jpadi4/ECE-445-Notebook/README.md

# ECE 445 Group 78
Digital lab notebook based off of this project: https://github.com/OfficialPouya/Safety_Suite_For_Electric_Longboard
