jpadi4/ECE-445-Notebook/Team Meetings/250416.md

# April 16, 2025
**In attendance:**
- Deepika Batra
- Li Padilla
- Rawnie Singh

## Meeting agenda
- Li soldered most of the capacitors, resistors, MCU, and IMU onto the board
    - this means the wheatstone bridge, strain gauge connectors, and IMU lowpass filter is on the PCB
- Rawnie & Deepika worked together to add on 3 connectors and ISP
- Confirmed expected functionality of addition of zener diode by supplying ~5V to MCU & programming.
