jpadi4/ECE-445-Notebook/Images/muscle_stretches/Lumbrical.jpg

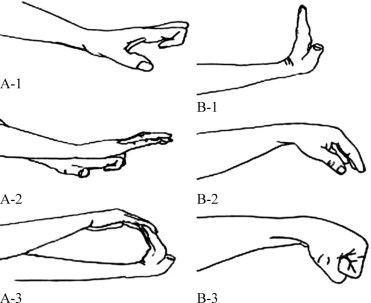
Images/muscle_stretches/Lumbrical.jpg
