jpadi4/ECE-445-Notebook/Images/muscle_stretches/Thenar1.jpg

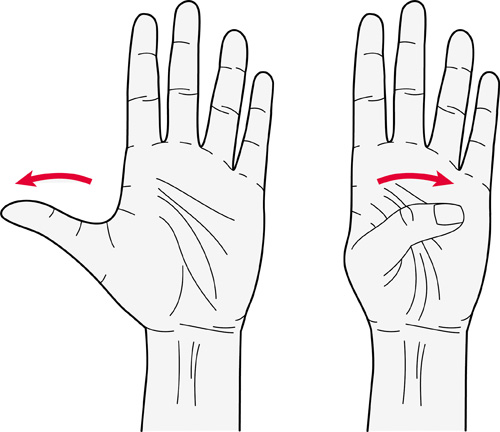
Images/muscle_stretches/Thenar1.jpg
