jpadi4/ECE-445-Notebook/Images/oldswitch.png

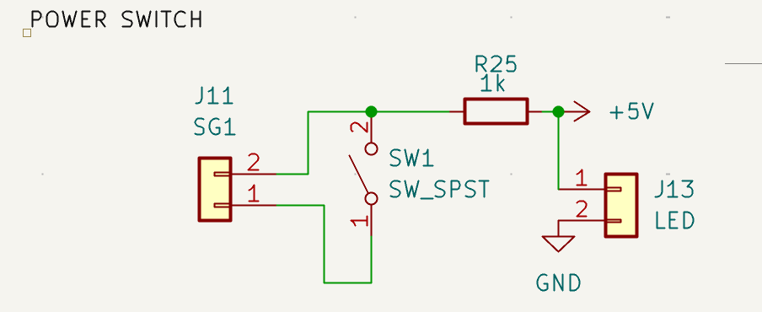
Images/oldswitch.png
