jpadi4/ECE-445-Notebook/Images/Screenshot 2025-04-30 at 11.05.38 AM.png

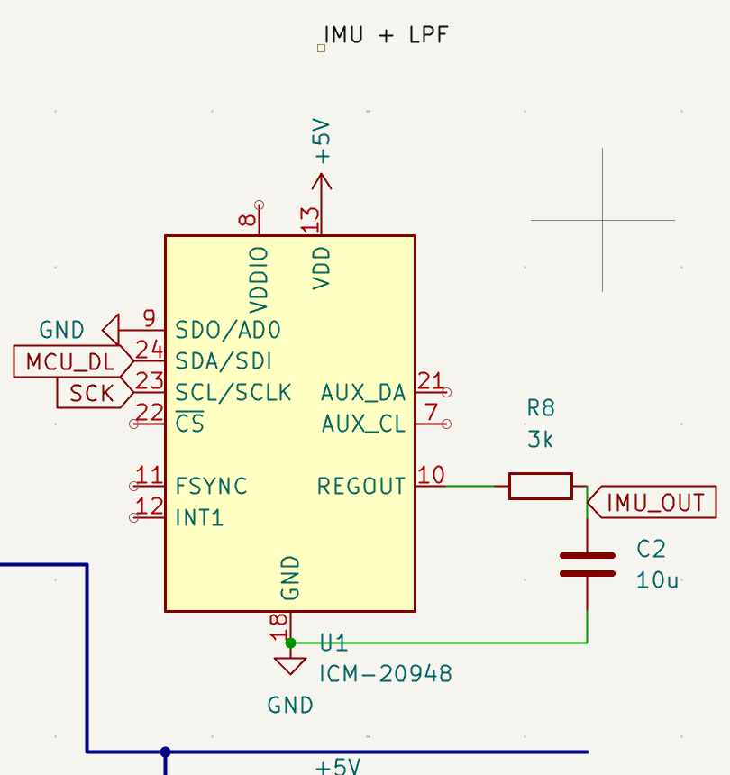
Images/Screenshot 2025-04-30 at 11.05.38 AM.png
