jpadi4/ECE-445-Notebook/Order Forms/ECE 445 Team 78 Order Form 1.27.2025.xlsx

Sheet: Order Form Fall 2024
ECE 445 SMD Component Request
 | TA Name: | Li, John |  | How to use this form:
Self Service Inventory (https://docs.google.com/spreadsheets/d/1InSHH3_mebTMyk4SWF0S2R67ZWSWq7FpKZRyKWeDHm0/edit?usp=sharing) | Group Number: | 78
E-Shop Webpage (https://ece.illinois.edu/about/eshop) | Date: | 2025-04-25 |  | 1. Enter the TA Name, Group Number, and date of request at the top.
 |  |  |  | 2. Use the drop downs to select the components needed by your team.
 | Component Requested | Quantity |  | 3. Send this form to your TA for approval and they will forward it to the E-Shop.
 | Micro Controller - ATmega328p | 3 | Maximum Quantity 3 | 4. Once the order is filled, your TA will be notified that it is available for pickup.
 |  |  | FALSE | 5. Only the TA that placed the order will be allowed to pick up the components, NO EXCEPTIONS.
 |  |  | FALSE
 |  |  | FALSE
 |  |  | FALSE
 |  |  | FALSE
 |  |  | FALSE
 |  |  | FALSE
 |  |  | FALSE
 |  |  | FALSE
 |  |  | FALSE
 |  |  | FALSE
 |  |  | FALSE
 |  |  | FALSE
 |  |  | FALSE
 |  |  | FALSE
 |  |  | FALSE
 |  |  | FALSE
 |  |  | FALSE
 |  |  | FALSE
 |  |  | FALSE
 |  |  | FALSE
 |  |  | FALSE
 |  |  | FALSE
 |  |  | FALSE
 |  |  | FALSE
 |  |  | FALSE
 |  |  | FALSE
 |  |  | FALSE
 |  |  | FALSE

Sheet: ESHOP SMD Component Guide
Component | Value | Description | Datasheet (If Known) | Part Number
Resistor - 0 Ω (0603) | 0 Ω (0603)
Resistor - 22 Ω (0603) | 22 Ω (0603) | RES 22 OHM 1% 1/10W 0603 | https://www.yageo.com/upload/media/product/products/datasheet/rchip/PYu-RC_Group_51_RoHS_L_12.pdf | RC0603FR-0722RL
Resistor - 43.2 Ω (0603) | 43.2 Ω (0603)
Resistor - 150 Ω (0603) | 150 Ω (0603)
Resistor - 182 Ω (0603) | 182 Ω (0603)
Resistor - 330 Ω (0603) | 330 Ω (0603)
Resistor - 332 Ω (0603) | 332 Ω (0603)
Resistor - 1k Ω (0603) | 1k Ω (0603)
Resistor - 4.7k Ω (0603) | 4.7k Ω (0603)
Resistor - 10k Ω (0603) | 10k Ω (0603)
Resistor - 20.5k Ω (0603) | 20.5k Ω (0603)
Resistor - 23.7k Ω (0603) | 23.7k Ω (0603)
Resistor - 27.4k Ω (0603) | 27.4k Ω (0603)
Resistor - 34k Ω (0603) | 34k Ω (0603)
Resistor - 0 Ω (0805) | 0 Ω (0805) | RES 0 OHM JUMPER 1/8W 0805 | https://www.seielect.com/catalog/sei-rmcf_rmcp.pdf | RMCF0805ZT0R00
Resistor - 330 Ω (0805) | 330 Ω (0805) | RES 330 OHM 1% 1/4W 0805 | https://www.koaspeer.com/pdfs/RK73H.pdf | RK73H2ATTD3300F
Resistor - 1k Ω (0805) | 1k Ω (0805) | RES 1K OHM 5% 1/8W 0805 | https://www.seielect.com/catalog/sei-rmcf_rmcp.pdf | RMCF0805JT1K00
Resistor - 1.5k Ω (0805) | 1.5k Ω (0805) | RES 1.5K OHM 1% 1/8W 0805 | https://www.seielect.com/catalog/sei-rmcf_rmcp.pdf | RMCF0805FT1K50
Resistor - 2.2k Ω (0805) | 2.2k Ω (0805) | RES 2.2K OHM 5% 1/8W 0805 | https://www.seielect.com/catalog/sei-rmcf_rmcp.pdf | RMCF0805JT2K20
Resistor - 5.1k Ω (0805) | 5.1k Ω (0805) | RES 5.1K OHM 5% 1/8W 0805 | https://www.seielect.com/catalog/sei-rmcf_rmcp.pdf | RMCF0805JT5K10
Resistor - 10k Ω (0805) | 10k Ω (0805) | RES 10K OHM 5% 1/8W 0805 | https://www.seielect.com/catalog/sei-rmcf_rmcp.pdf | RMCF0805JG10K0
Resistor - 100k Ω (0805) | 100k Ω (0805) | RES 100K OHM 5% 1/8W 0805 | https://www.seielect.com/catalog/sei-rmcf_rmcp.pdf | RMCF0805JT100K
Resistor - 1M Ω (0805) | 1M Ω (0805) | RES 1M OHM 1% 1/8W 0805 | https://www.seielect.com/catalog/sei-rmcf_rmcp.pdf | RMCF0805FG1M00
Capacitor - 10 pF (0603) | 10 pF (0603) | CAP CER 10PF 50V C0G/NP0 0603 | http://www.passivecomponent.com/wp-content/uploads/datasheet/WTC_MLCC_General_Purpose.pdf | 0603N100J500CT
Capacitor - 22 pF (0603) | 22 pF (0603) | CAP CER 22PF 50V C0G/NP0 0603 | http://www.passivecomponent.com/wp-content/uploads/datasheet/WTC_MLCC_General_Purpose.pdf | 0603N220J500CT
Capacitor - .01µF | .01µF | CAP CER .01 µF 16V X7R 0603 | https://connect.kemet.com:7667/gateway/IntelliData-ComponentDocumentation/1.0/download/datasheet/C0603C103K4RACTU | C0603C103K4RAC7867
Capacitor - .1µF | .1µF | CAP CER 0.1UF 16V X7R 0603 | https://connect.kemet.com:7667/gateway/IntelliData-ComponentDocumentation/1.0/download/datasheet/C0603C104K4RACTU | C0603C104K4RAC7867
Capacitor - .22µF | .22µF | CAP CER 0.22UF 10V X7R 0603 | https://connect.kemet.com:7667/gateway/IntelliData-ComponentDocumentation/1.0/download/datasheet/C0603C224K8RACTU | C0603C224K8RAC7867
Capacitor - 1µF | 1µF | CAP CER 1UF 6.3V X5R 0603 | https://connect.kemet.com:7667/gateway/IntelliData-ComponentDocumentation/1.0/download/datasheet/C0603C105K9PACTU | C0603C105K9PAC7867
Capacitor - 4.7µF | 4.7µF | CAP CER 4.7UF 6.3V X5R 0603 | https://connect.kemet.com:7667/gateway/IntelliData-ComponentDocumentation/1.0/download/datasheet/C0603C475K9PACTU | C0603C475K9PAC7867
Capacitor - .001 µF (0805) | .001 µF (0805) | CAP CER .001µF 50V X7R 0805 | https://www.samsungsem.com/kr/support/product-search/mlcc/CL21B102KBANNNC.jsp | CL21B102KBANNNC
Capacitor - .01µF (0805) | .01µF (0805) | CAP CER .01µF 100V X7R 0805 | http://www.samsungsem.com/kr/support/product-search/mlcc/CL21B103KCANNNC.jsp | CL21B103KCANNNC
Capacitor - .1 µF (0805) | .1 µF (0805) | CAP CER 0.1UF 25V Y5V 0805 | https://www.samsungsem.com/resources/file/global/support/product_catalog/MLCC.pdf | CL21F104ZAANNNC
Capacitor - 1 µF (0805) | 1 µF (0805) | CAP CER 1UF 50V X7R 0805 |  | CL21B105KBFNNNG
Capacitor - 4.7 µF (0805) | 4.7 µF (0805) | CAP CER 4.7UF 25V X5R 0805 |  | CL21A475KAQNNNE
Capacitor - 10 µF (0805) | 10 µF (0805) | CAP CER 10UF 50V X5R 0805 | https://search.murata.co.jp/Ceramy/image/img/A01X/G101/ENG/GRM21BR61H106ME43-01A.pdf | GRM21BR61H106ME43L
Capacitor - 33 µF (0805) | 33 µF (0805) | CAP CER 33UF 10V X5R 0805 | https://product.tdk.com/system/files/dam/doc/product/capacitor/ceramic/mlcc/catalog/mlcc_commercial_general_en.pdf | C2012X5R1A336M125AC
Voltage Regulator - AZ1117CD-3.3TRG1 | AZ1117CD-3.3TRG1 | IC REG LINEAR 3.3V 1A TO252-2 | https://www.diodes.com/assets/Datasheets/AZ1117C.pdf | AZ1117CD-3.3TRG1
Voltage Regulator - AP2112K-3.3TRG1 | AP2112K-3.3TRG1 | IC REG LINEAR 3.3V 600MA SOT25 | https://www.diodes.com/assets/Datasheets/AP2112.pdf | AP2112K-3.3TRG1
Voltage Regulator - BD50FC0FP-E2 | BD50FC0FP-E2 | IC REG LINEAR 5V 1A TO252-3 | https://www.rohm.com/datasheet?p=BD50FC0FP&dist=Digi-key&media=referral&campaign=Digi-key | BD50FC0FP-E2
Voltage Regulator - TPS7A2050PDBVR | TPS7A2050PDBVR | IC REG LINEAR 5V 300MA SOT23-5 | https://www.ti.com/general/docs/suppproductinfo.tsp?distId=10 | TPS7A2050PDBVR
Diode - CDBA540-HF | CDBA540-HF | DIODE SCHOTTKY 40V 5A DO214AC |  | CDBA540-HF
Diode - 1SMB5919BT3 | 1SMB5919BT3 | DIODE ZENER 5.6V 3W SMB |  | 1SMB5919BT3
Diode - SP0503BAHTG | SP0503BAHTG | TVS DIODE 5.5VWM 8.5VC SOT143-4 | https://www.littelfuse.com/~/media/electronics/datasheets/tvs_diode_arrays/littelfuse_tvs_diode_array_sp05_datasheet.pdf.pdf | SP0503BAHTG
Diode - BAT54SLT1G | BAT54SLT1G | DIODE ARR SCHOTT 30V 200MA SOT23 | https://www.onsemi.com/pdf/datasheet/bat54slt1-d.pdf | BAT54SLT1G
Diode - LTST-C150CKT | LTST-C150CKT | LED RED CLEAR 1206 SMD | https://optoelectronics.liteon.com/upload/download/DS-22-98-0002/LTST-C150CKT.pdf | LTST-C150CKT
Fuse - 0451002.MRL | 0451002.MRL | FUSE BRD MNT 2A 125VAC/VDC 2SMD | https://www.littelfuse.com/media?itemid=533cd5cc-956c-4243-867f-6ab5a62f6ba1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 | 0451002.MRL
Transistor - SS8050-G | SS8050-G | TRANS NPN 25V 1.5A SOT23-3 | https://www.comchiptech.com/admin/files/product/SS8050-G RevA181526.pdf | SS8050-G
IC - UCC27324DGNRG4 | UCC27324DGNRG4 | IC GATE DRVR LOW-SIDE 8MSOP | https://www.ti.com/lit/ds/symlink/ucc37323.pdf | UCC27324DGNRG4
IC - UCC25705DGKTR | UCC25705DGKTR | IC REG CTRLR MULT TOP 8VSSOP | https://www.ti.com/lit/ds/slus473b/slus473b.pdf | UCC25705DGKTR
Comparator - LM393DR2 | LM393DR2 | IC COMP DUAL OFFSET LV 8SOIC | https://www.onsemi.com/pdf/datasheet/lm393-d.pdf | LM393DR2
Timer - TL555CDT | TL555CDT |  |  | TL555CDT
Op Amp - LMV922MX | LMV922MX |  |  | LMV922MX
Op Amp - UA741CDT | UA741CDT | IC OPAMP GP 1 CIRCUIT 8SOIC | https://www.st.com/content/ccc/resource/technical/document/datasheet/group1/d6/9e/4e/8a/fa/65/4c/d0/CD00001252/files/CD00001252.pdf/jcr:content/translations/e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 | UA741CDT
Ferrite Bead - MI0805K400R-10 | MI0805K400R-10 | FERRITE BEAD 40 OHM 0805 1LN | https://www.laird.com/document/datasheet/mi0805k400r-10-datasheet | MI0805K400R-10
MOSFET - IRLML0030TRPBF | IRLML0030TRPBF | MOSFET N-CH 30V 5.3A SOT23 | https://www.infineon.com/dgdl/irlml0030pbf.pdf?fileId=5546d462533600a401535664773825df | IRLML0030TRPBF
MOSFET - DMP2045U-7 | DMP2045U-7 | MOSFET P-CH 20V 4.3A SOT23 | https://www.diodes.com/assets/Datasheets/DMP2045U.pdf | DMP2045U-7
MOSFET - 2N7002MTF | 2N7002MTF | MOSFET N-CH 60V 115MA SOT23-3 |  | 2N7002MTF
MOSFET - FDS6680A | FDS6680A | MOSFET N-CH 30V 12.5A 8SOIC | https://www.onsemi.com/pdf/datasheet/fds6680a-d.pdf | FDS6680A
MOSFET - IRFR18N15DPBF | IRFR18N15DPBF | MOSFET N-CH 150V 18A DPAK | https://www.infineon.com/dgdl/irfr18n15dpbf.pdf?fileId=5546d462533600a40153562d7a002069 | IRFR18N15DPBF
MOSFET - SI7846DP-T1 | SI7846DP-T1 |  |  | SI7846DP-T1
MOSFET - IRLL014NTRPBF | IRLL014NTRPBF | MOSFET N-CH 55V 2A SOT223 | https://www.infineon.com/dgdl/irll014npbf.pdf?fileId=5546d462533600a401535664368425cf | IRLL014NTRPBF
Micro Controller (3 Max) - ESP32-S3-WROOM | ESP32-S3-WROOM | RF TXRX MODULE BT PCB TRACE SMD | https://www.espressif.com/sites/default/files/documentation/esp32-s3-wroom-1_wroom-1u_datasheet_en.pdf | ESP32-S3-WROOM-1-N16
Micro Controller (3 Max) - ATmega32u4 | ATmega32u4 | IC MCU 8BIT 32KB FLASH 44TQFP | http://ww1.microchip.com/downloads/en/DeviceDoc/Atmel-7766-8-bit-AVR-ATmega16U4-32U4_Summary.pdf | ATMEGA32U4-AUR
Micro Controller (3 Max) - ATmega328p | ATmega328p | IC MCU 8BIT 32KB FLASH 32TQFP | https://ww1.microchip.com/downloads/en/DeviceDoc/ATmega48A-PA-88A-PA-168A-PA-328-P-DS-DS40002061B.pdf | ATMEGA328P-AUR
Micro Controller (3 Max) - STM32F103C8 | STM32F103C8 | IC MCU 32BIT 64KB FLASH 48LQFP | https://www.st.com/resource/en/datasheet/stm32f103cb.pdf | STM32F103C8T6TR
Micro Controller (3 Max) - STM32F401RBT6 | STM32F401RBT6 | IC MCU 32BIT 128KB FLASH 64LQFP | https://www.st.com/content/ccc/resource/technical/document/datasheet/9e/50/b1/5a/5f/ae/4d/c1/DM00086815.pdf/files/DM00086815.pdf/jcr:content/translations/en.D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 | STM32F401RBT6
Connector - Micro USB-B Connector | Micro USB-B Connector | CONN RCPT USB2.0 MICRO B SMD R/A | https://www.amphenol-cs.com/media/wysiwyg/files/drawing/10118194.pdf | 10118194-0001LF
Switch - Switch Tactile | Switch Tactile | SWITCH TACTILE SPST-NO 0.05A 12V | https://www.ckswitches.com/media/1471/pts645.pdf | PTS645SL43SMTR92 LFS
Header - 4 Position Female Dupont | 4 Position Female Dupont | CONN HDR 4POS 0.1 TIN PCB |  | PPTC041LFBN-RC
Header - 3 Position Female Dupont | 3 Position Female Dupont | CONN HDR 3POS 0.1 GOLD PCB |  | PPPC031LFBN-RC
Header - 3x2 Programming Header | 3x2 Programming Header | CONN HEADER VERT 6POS 2.54MM | https://www.we-online.com/components/products/datasheet/61200621621.pdf | 61200621621
Header - 5x2 Programming Header | 5x2 Programming Header | CONN HEADER VERT 10POS 2.54MM |  | 302-S101
Connector - Edge Launch SMA Connector | Edge Launch SMA Connector | CONN SMA JACK STR 50OHM EDGE MNT |  | SMA-J-P-H-ST-EM1
Connector - 2 position terminal block (15A) | 2 position terminal block (15A) | TERM BLK 2P SIDE ENT 5.08MM PCB | https://www.phoenixcontact.com/us/products/1715721/pdf | 1715721
PC Test Point - Yellow Test Point | Yellow Test Point |  |  | 5014
PC Test Point - Orange Test Point | Orange Test Point |  |  | 5013
PC Test Point - White Test Point | White Test Point |  |  | 5012
PC Test Point - Black Test Point | Black Test Point |  |  | 5011
PC Test Point - Red Test Point | Red Test Point |  |  | 5010
