jpadi4/ECE-445-Notebook/KiCad Files/445pcb_round3.kicad_pcb

## KiCad design KiCad Files/445pcb_round3.kicad_pcb (2025-04-28)

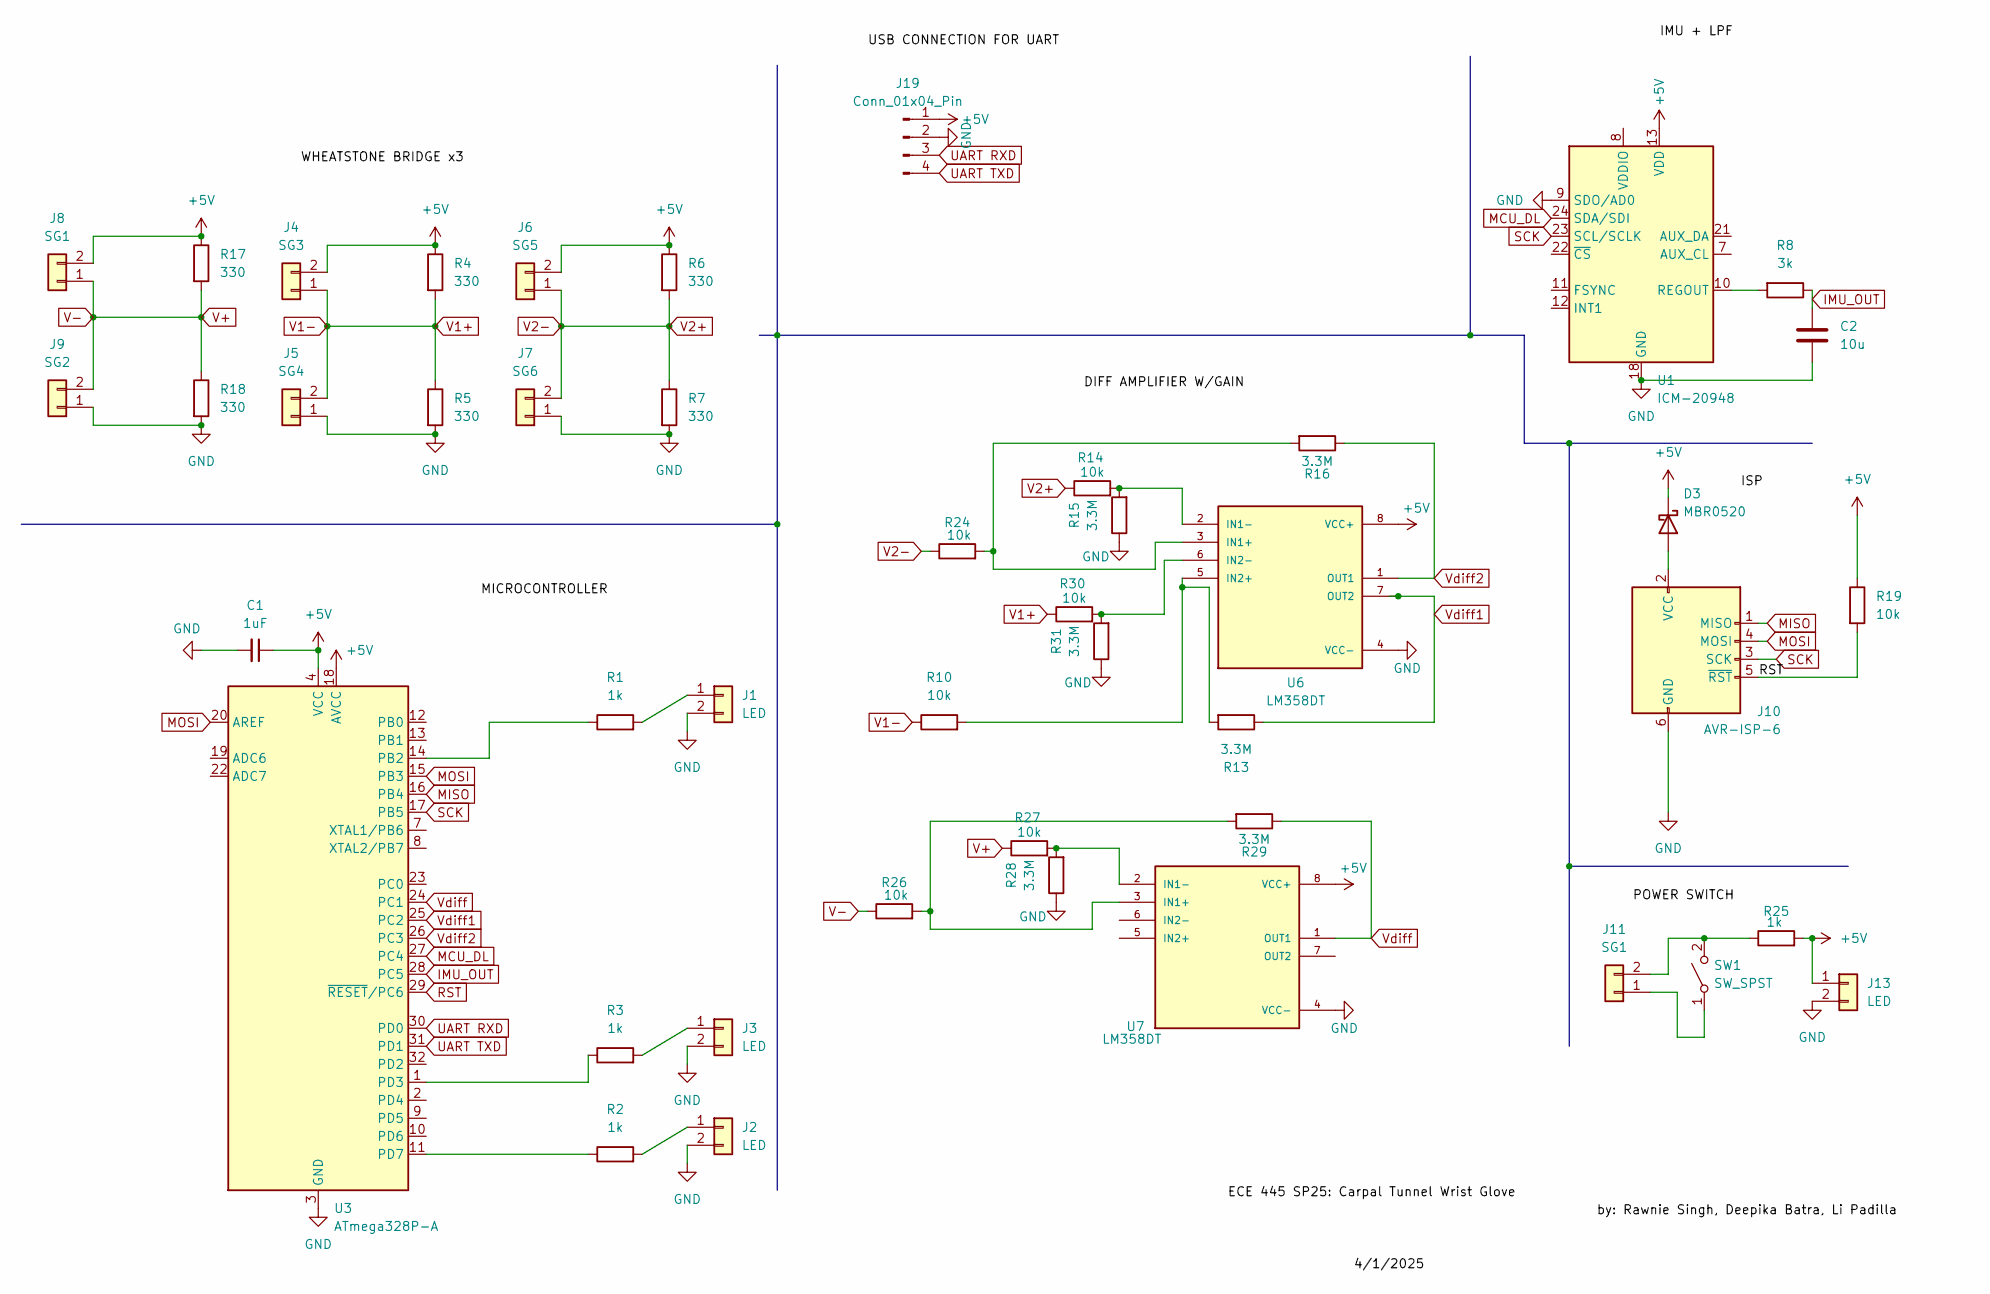
[picture p20: schematic 445pcb_round3.kicad_sch]

Parts:
C1: 1uF; C_0805_2012Metric_Pad1.18x1.45mm_HandSolder
C2: 10u; C_0805_2012Metric_Pad1.18x1.45mm_HandSolder
D3: MBR0520; D_SOD-123
J1, J2, J3, J13: LED; Molex_KK-254_AE-6410-02A_1x02_P2.54mm_Vertical
J4: SG3; Molex_KK-254_AE-6410-02A_1x02_P2.54mm_Vertical
J5: SG4; Molex_KK-254_AE-6410-02A_1x02_P2.54mm_Vertical
J6: SG5; Molex_KK-254_AE-6410-02A_1x02_P2.54mm_Vertical
J7: SG6; Molex_KK-254_AE-6410-02A_1x02_P2.54mm_Vertical
J8, J11: SG1; Molex_KK-254_AE-6410-02A_1x02_P2.54mm_Vertical
J9: SG2; Molex_KK-254_AE-6410-02A_1x02_P2.54mm_Vertical
J10: AVR-ISP-6; IDC-Header_2x03_P2.54mm_Vertical
J19: Conn_01x04_Pin; Molex_KK-254_AE-6410-04A_1x04_P2.54mm_Vertical
R1, R2, R3, R25: 1k; R_0805_2012Metric_Pad1.20x1.40mm_HandSolder
R4, R5, R6, R7, R17, R18: 330; R_0805_2012Metric_Pad1.20x1.40mm_HandSolder
R8: 3k; R_0805_2012Metric_Pad1.20x1.40mm_HandSolder
R10, R14, R19, R24, R26, R27, R30: 10k; R_0805_2012Metric_Pad1.20x1.40mm_HandSolder
R13, R15, R16, R28, R29, R31: 3.3M; R_0805_2012Metric_Pad1.20x1.40mm_HandSolder
SW1: SW_SPST; SW_DIP_SPSTx01_Slide_9.78x4.72mm_W7.62mm_P2.54mm
U1: ICM-20948; InvenSense_QFN-24_3x3mm_P0.4mm
U3: ATmega328P-A; TQFP-32_7x7mm_P0.8mm
U6, U7: LM358DT; SOIC-8_3.9x4.9mm_P1.27mm

Connections:
+5V: C1.1, D3.1 (K), J4.2, J6.2, J8.2, J13.1, J19.1, R4.1, R6.1, R17.1, R19.1, R25.2, U1.13 (VDD), U3.4 (VCC), U3.6 (VCC), U3.18 (AVCC), U6.8 (VCC+), U7.8 (VCC+)
GND: C1.2, C2.2, J1.2, J2.2, J3.2, J5.1, J7.1, J9.1, J10.6 (GND), J13.2, J19.2, R5.2, R7.2, R15.1, R18.2, R28.1, R31.1, U1.9 (SDO/AD0), U1.18 (GND), U1.20 (GND), U3.3 (GND), U3.5 (GND), U3.21 (GND), U6.4 (VCC-), U7.4 (VCC-)
IMU_OUT: C2.1, R8.1, U3.28 (PC5)
MCU_DL: U1.24 (SDA/SDI), U3.27 (PC4)
MISO: J10.1 (MISO), U3.16 (PB4)
MOSI: J10.4 (MOSI), U3.15 (PB3), U3.20 (AREF)
unnamed: D3.2 (A), J10.2 (VCC)
unnamed: J1.1, R1.2
unnamed: J2.1, R2.2
unnamed: J3.1, R3.2
unnamed: J11.1, SW1.1 (A)
unnamed: J11.2, R25.1, SW1.2 (B)
unnamed: R8.2, U1.10 (REGOUT)
unnamed: R1.1, U3.14 (PB2)
unnamed: R3.1, U3.1 (PD3)
unnamed: R2.1, U3.11 (PD7)
unnamed: R16.2, R24.2, U6.3 (IN1+)
unnamed: R14.2, R15.2, U6.2 (IN1-)
unnamed: R10.2, R13.2, U6.5 (IN2+)
unnamed: R30.2, R31.2, U6.6 (IN2-)
unnamed: R26.2, R29.2, U7.3 (IN1+)
unnamed: R27.2, R28.2, U7.2 (IN1-)
RST: J10.5 (~RST), R19.2, U3.29 (~RESET/PC6)
SCK: J10.3 (SCK), U1.23 (SCL/SCLK), U3.17 (PB5)
UART RXD: J19.3, U3.30 (PD0)
UART TXD: J19.4, U3.31 (PD1)
V1+: J4.1, J5.2, R4.2, R5.1, R10.1, R30.1
V2+: J6.1, J7.2, R6.2, R7.1, R14.1, R24.1
V+: J8.1, J9.2, R17.2, R18.1, R26.1, R27.1
Vdiff: R29.1, U3.24 (PC1), U7.1 (OUT1)
Vdiff1: R13.1, U3.25 (PC2), U6.7 (OUT2)
Vdiff2: R16.1, U3.26 (PC3), U6.1 (OUT1)

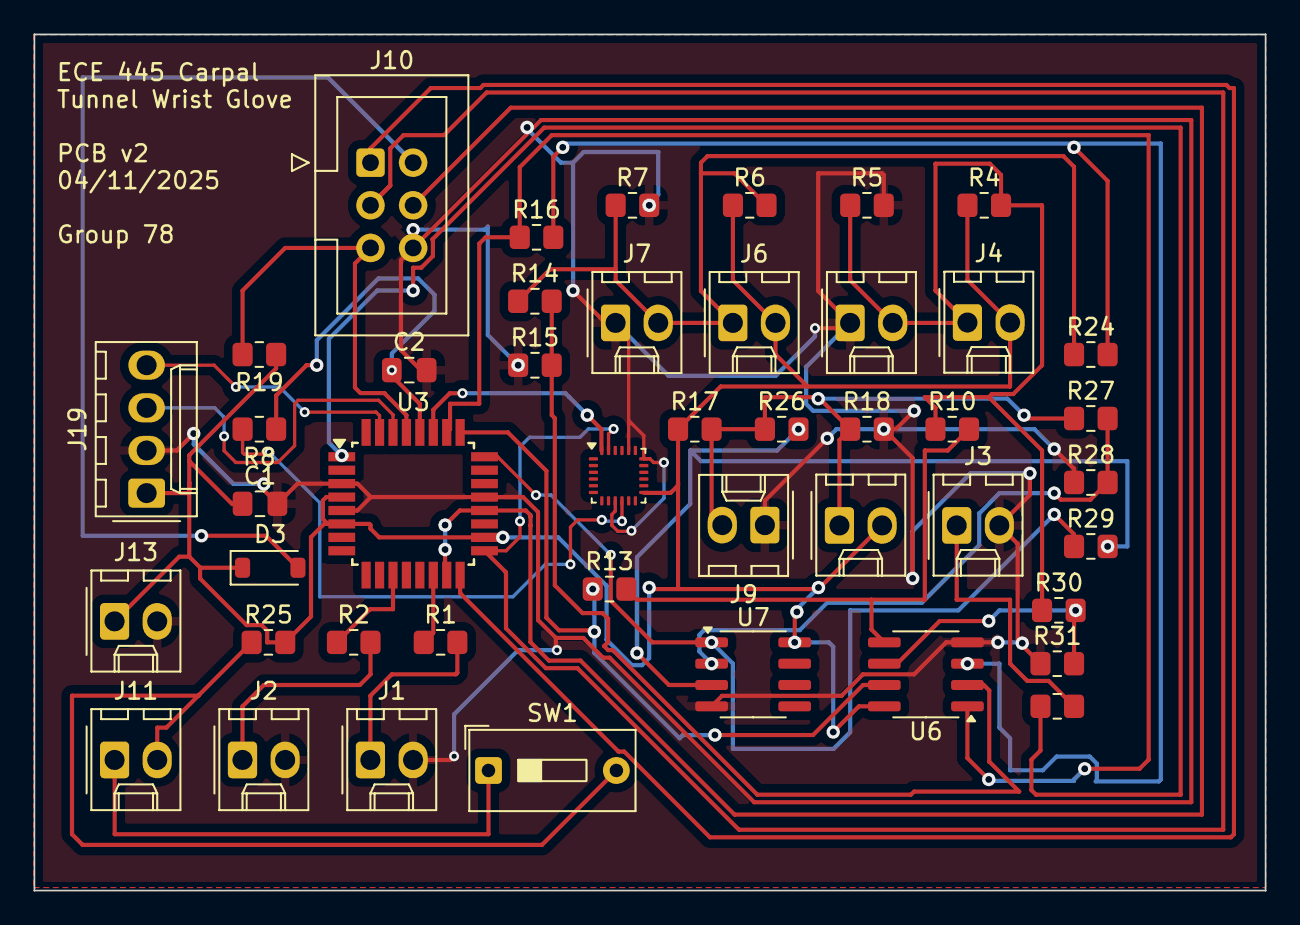
[picture p21: board 445pcb_round3.kicad_pcb from above]

Board: 2 copper layers, 73.3 x 51.0 mm, 45 parts (0 on the bottom side), 32 nets.
