jpadi4/ECE-445-Notebook/(commit log)

2025-03-10 Add new Arduino program
2025-04-02 kicad round3 schematic
    [445pcb_round3.kicad_sch]
2025-04-15 notebook meetings update
    [ECE 445 Group 78 Order Form 1.27.2025.xlsx]
2025-04-16 Explained LED program for 3 strain gauges
2025-04-20 test programs for LED on PCB
2025-04-20 Update the test LED program for 3 wheatstone bridges to use the proper pins
2025-04-20 Upload backup PCB files, update team meeting agendas
2025-04-20 Update LED programs; create Program to just light up LEDs
2025-04-24 adding power to op-amps, switching USB to connector, zener diode
    [445pcb_round3.kicad_pcb, 445pcb_round3.kicad_sch]
2025-04-24 IMU connections for new PCB
    [445pcb_round3.kicad_pcb]
2025-04-29 add 4/28 meeting
    [ECE 445 Team 78 Order Form 1.27.2025.xlsx, ECE 445 Team 78 Order Form 4.28.xlsx]
2025-04-29 successful hello world UART program + run
2025-04-30 add some research done for the IMU
2025-04-30 notes on grounding capacitor for schottky schematic
2025-04-30 add IMU code to test reading REGOUT
2025-04-30 add arduino program to read all of the sensor signals and output to UART
2025-04-30 analogrd.ino does not do voltage conversion
2025-04-30 Clean up repository folders
    [445pcb_round3.kicad_pcb, 445pcb_round3.kicad_sch, ECE 445 Group 78 Order Form 1.27.2025.xlsx, ECE 445 Team 78 Order Form 1.27.2025.xlsx, ECE 445 Team 78 Order Form 4.28.xlsx]
2025-05-09 mock IMU data + analysis
2025-05-09 update 250423.md with correct schematic
